coblader/mousedroid/cad/comments2.png

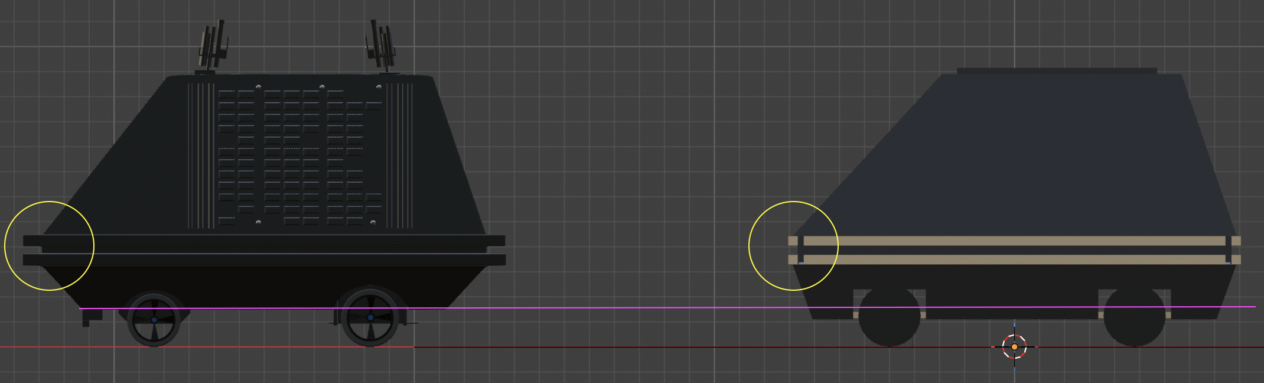
cad/comments2.png
