coblader/mousedroid/cad/comments.png

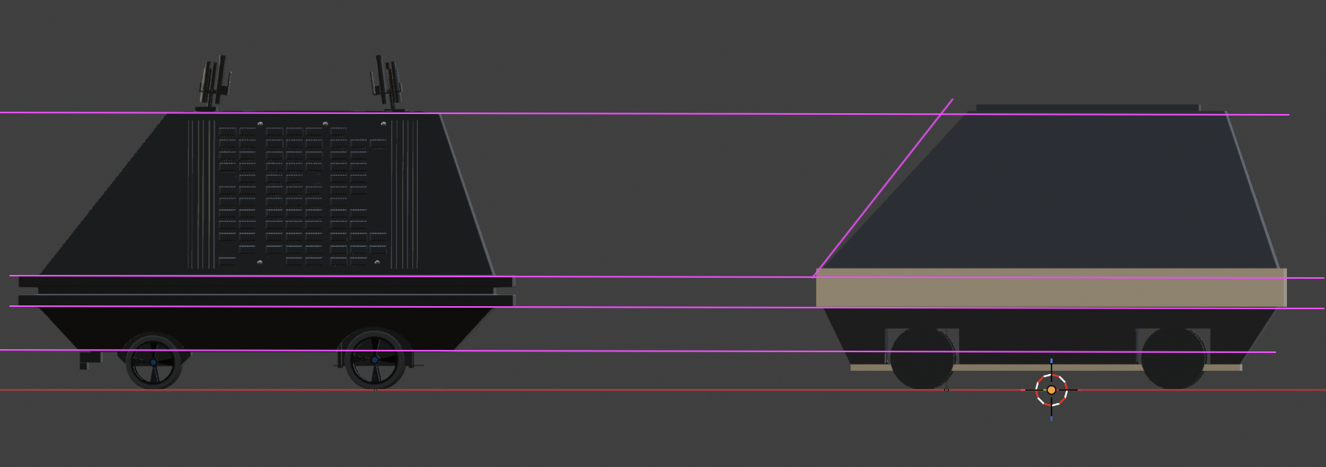
cad/comments.png
