coblader/mousedroid/chassis/4wd-mecanum-wheel-robot-chassis-metal-frame.jpg.webp

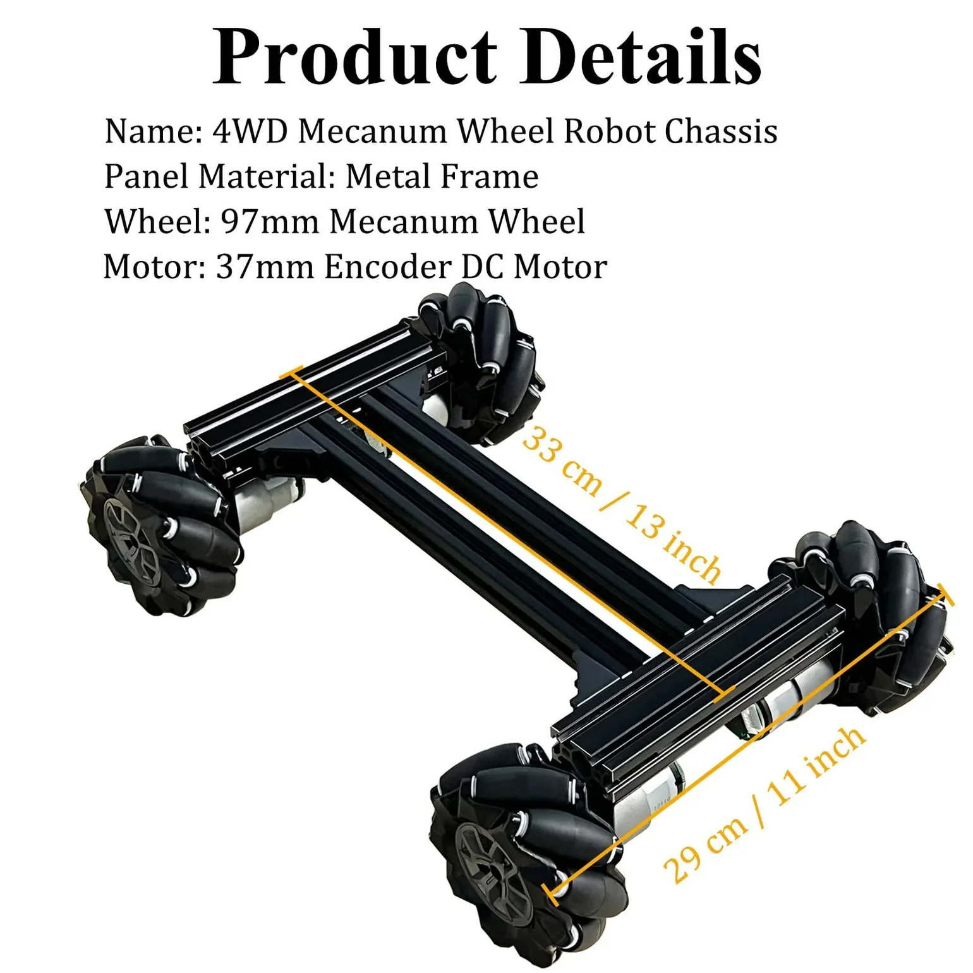
chassis/4wd-mecanum-wheel-robot-chassis-metal-frame.jpg.webp
