coblader/mousedroid/chassis/4wd-mecanum-wheel-robot-chassis-side-view.jpg.webp

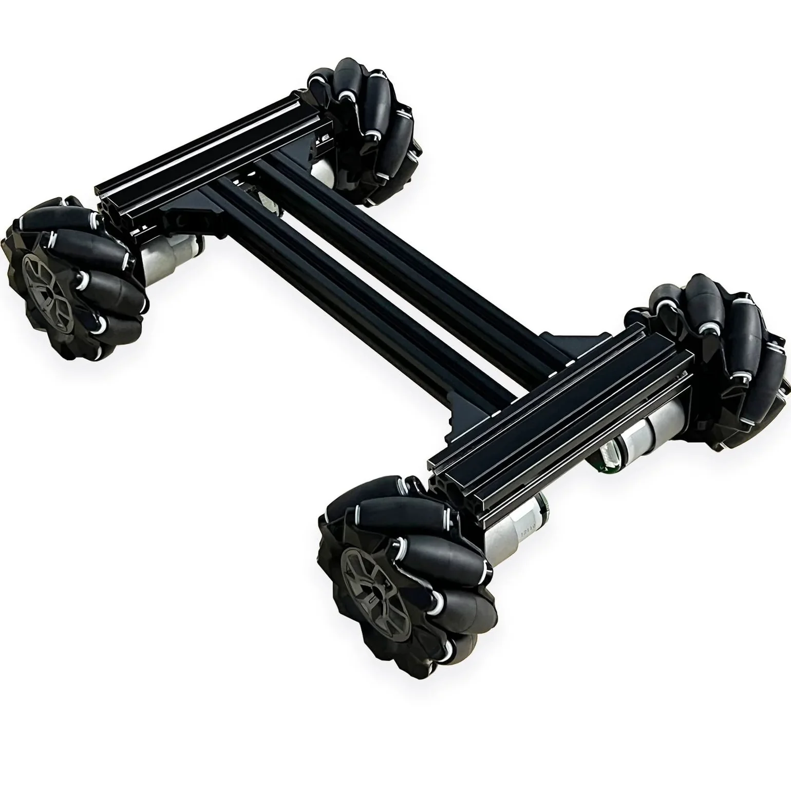
chassis/4wd-mecanum-wheel-robot-chassis-side-view.jpg.webp
