coblader/mousedroid/chassis/4wd-mecanum-wheel-robot-metal-chassis-kit.jpg.webp

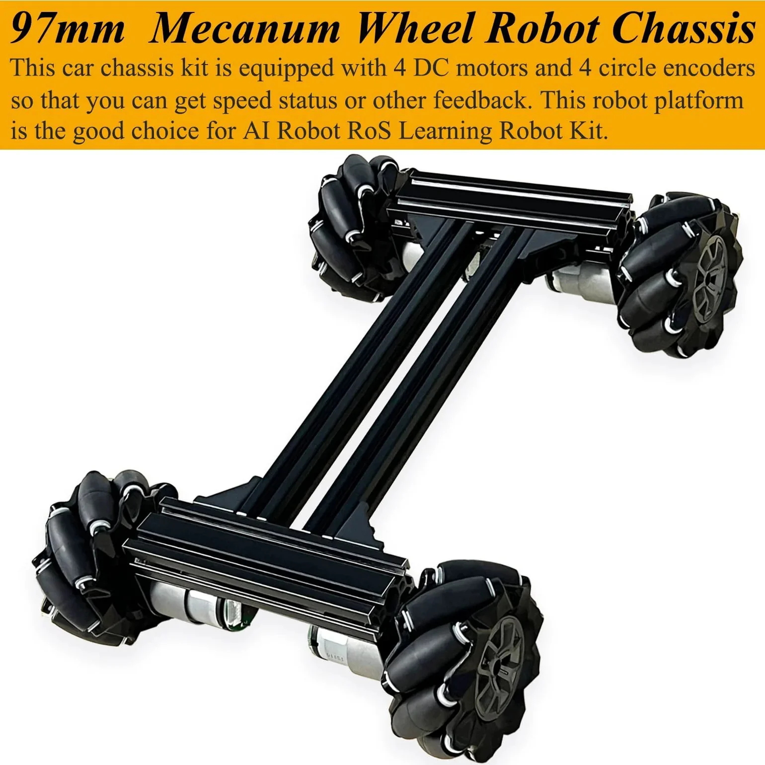
chassis/4wd-mecanum-wheel-robot-metal-chassis-kit.jpg.webp
