coblader/mousedroid/chassis/4wd-mecanum-wheel-robot-metal-frame-black.jpg.webp

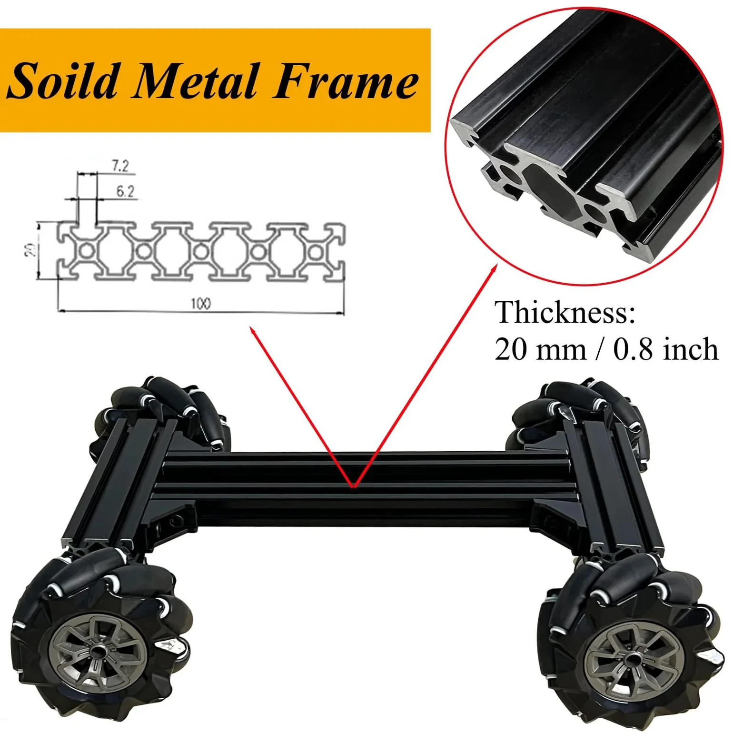
chassis/4wd-mecanum-wheel-robot-metal-frame-black.jpg.webp
