coblader/mousedroid/chassis/4wd-mecanum-wheel-robot-motor-encoder-diagram.jpg.webp

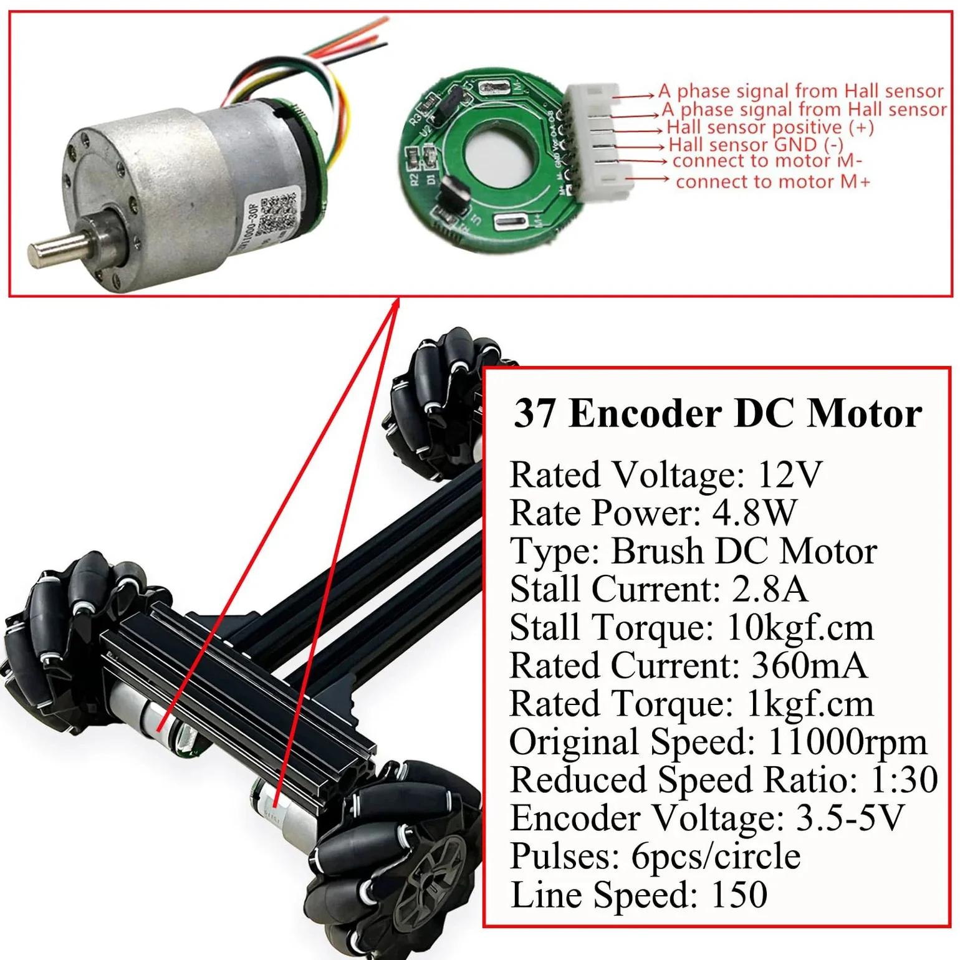
chassis/4wd-mecanum-wheel-robot-motor-encoder-diagram.jpg.webp
