coblader/mousedroid/chassis/97mm-mecanum-wheel-diagram-and-design.jpg.webp

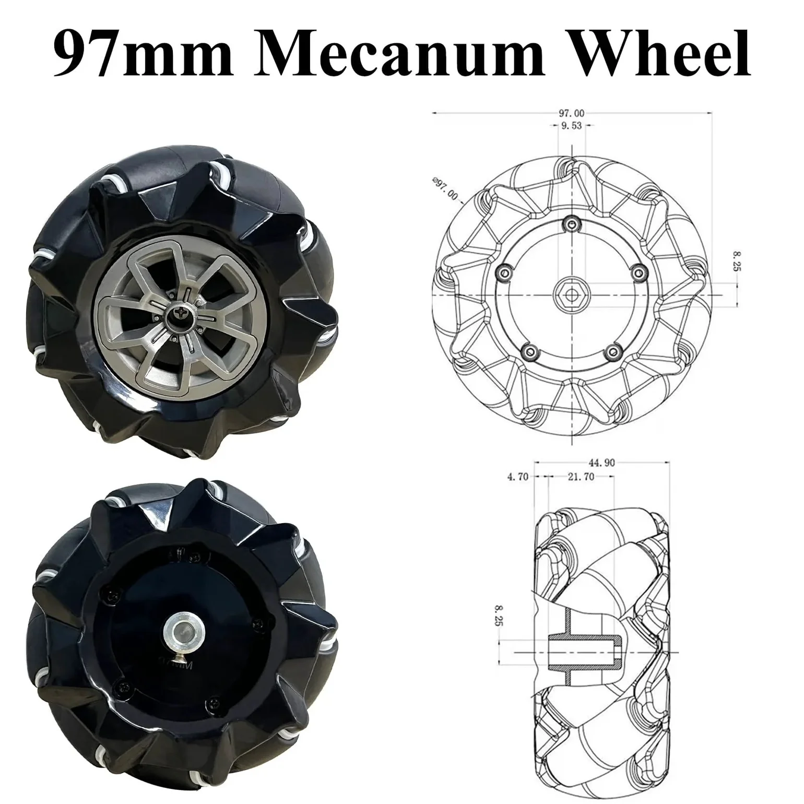
chassis/97mm-mecanum-wheel-diagram-and-design.jpg.webp
