coblader/mousedroid/chassis/chassis.png

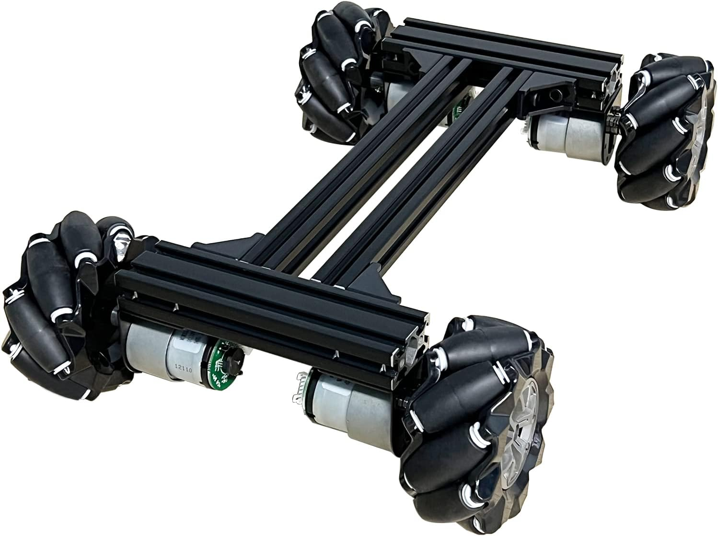
chassis/chassis.png
