coblader/mousedroid/firmware/encoder.png

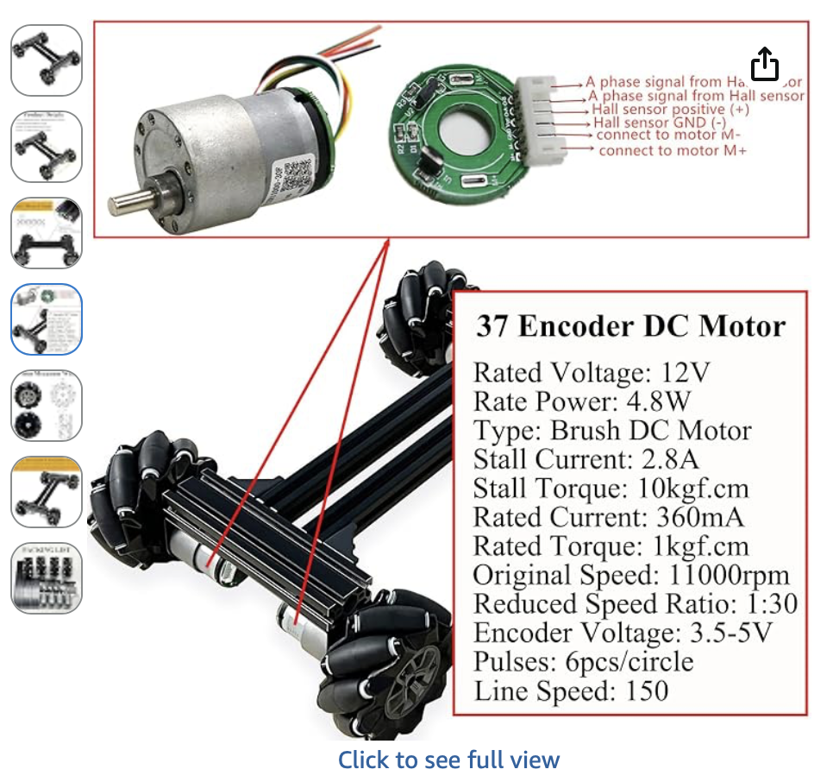
firmware/encoder.png
