coblader/mousedroid/chassis/4wd-mecanum-wheel-robot-parts-kit.jpg.webp

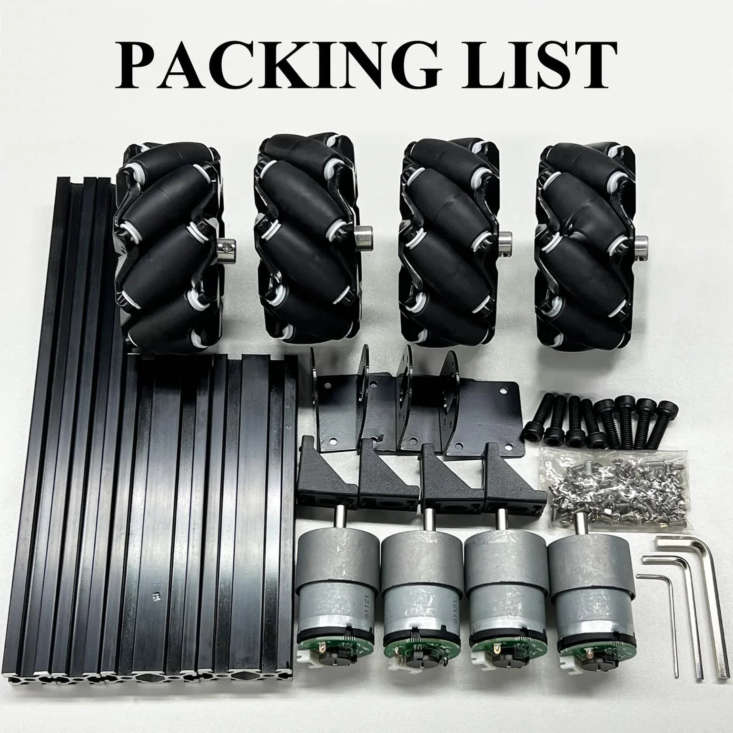
chassis/4wd-mecanum-wheel-robot-parts-kit.jpg.webp
