coblader/mousedroid/cad/Mse-6/Mse-6-for-animation/Mse.OBJ-.MTL/Mse6-WithoutWheels/Msewithoutwheels.obj

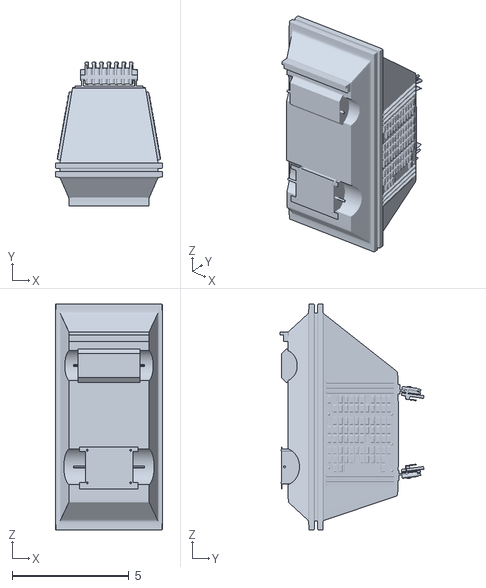
[picture p12: CAD file, 2026-07-14]
cad/Mse-6/Mse-6-for-animation/Mse.OBJ-.MTL/Mse6-WithoutWheels/Msewithoutwheels.obj
4.57 x 6.15 x 9.66
