coblader/mousedroid/cad/Mse-6/Mse-6-for-animation/Mse.OBJ-.MTL/Wheels/wheels.obj

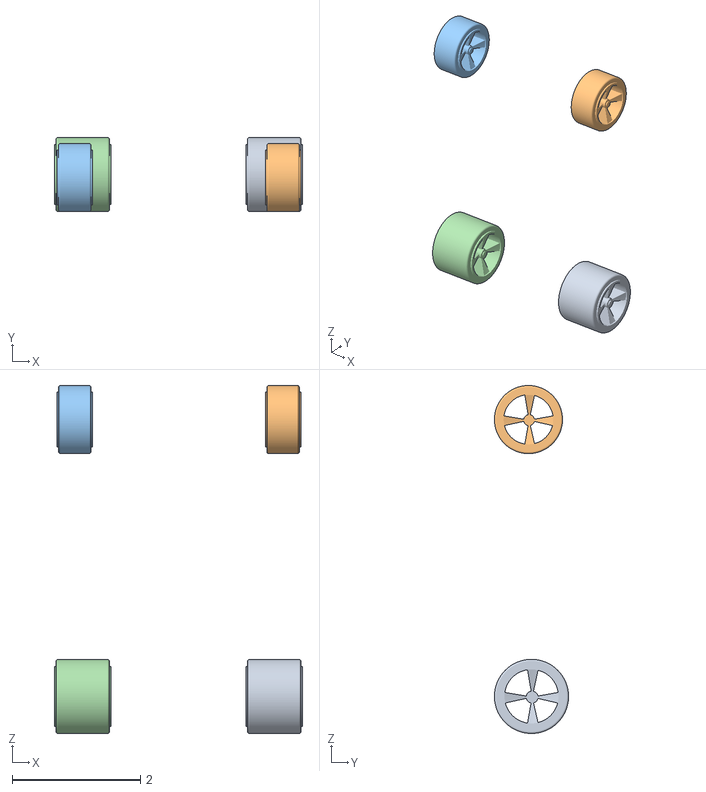
[picture p13: CAD file, 2026-07-14]
cad/Mse-6/Mse-6-for-animation/Mse.OBJ-.MTL/Wheels/wheels.obj
3.88 x 1.16 x 5.44
wheel2right_Circle.002
wheel1right_Circle.001
wheel1left_Circle.004
wheel2left_Circle.003
