coblader/mousedroid/(list of files, cad)

Other CAD files:
cad/mouse-droid.blend
