coblader/mousedroid/firmware/WIRING.md

# Mouse Droid — Wiring

Skid-steer 4WD. Left pair of motors on BTS7960 #1, right pair on BTS7960 #2.
Arduino Uno = motor controller (USB-powered from Jetson). One encoder channel read
per side (**single-channel** — 3 of 4 encoder A channels are dead; see below).

## 1. Power distribution (thick wire, 12–14 AWG)

```
        3S LiPo 11.1V ── XT60
             │ (+)
             ▼
      [ 15A inline fuse ]
             │
             ▼
      [ 20A main switch ]
             │  +12V (switched) bus
   ┌─────────┼───────────────────┬───────────────────────┐
   ▼         ▼                   ▼                        ▼
BTS7960 #1  BTS7960 #2      Buck-boost IN            (Vbat divider tap,
 B+  B-      B+  B-          IN+   IN-                 see signal view)
                              │ OUT = 12V
                              ▼
                    [ 5.5x2.5 barrel, CENTER +] ── verify with meter!
                              ▼
                    Jetson Orin Nano DC jack

GROUND BUS (battery −):  battery− ─ BTS7960#1 B− ─ BTS7960#2 B− ─
                         buck-boost IN− ─ Arduino GND ─ MPU6050 GND ─
                         divider GND   (ALL tied together — one common ground)
```

**Main on/off switch:** SPST in the **+12 V line, right after the fuse** — one
terminal from the fuse output, the other to the +12 V bus (it breaks the positive
only; ground stays continuous). Carries full system current, so use thick 12–14
AWG (20 A switch > 15 A fuse). An *illuminated* rocker has a 3rd terminal = lamp
(−) → common ground. The switch cuts **everything**, including the Jetson.

**LiPo low-voltage buzzer:** standalone alarm — plugs into the pack's **JST-XH
balance lead**; not wired to the Arduino or the bus. Per-cell audible warning that
complements the firmware cutoff (see BUILD.md §5).

**Jetson audio peripherals (NOT on the Arduino):** the speaker (MAX98357A I²S amp
off the Orin 40-pin I²S + 5 V) and the ReSpeaker USB mic array (USB) connect to the
**Jetson**. See BUILD.md §3 (BOM) and §8 (voice → VLM pipeline).

## 2. Motors (each driver runs its two motors in parallel)

```
BTS7960 #1 (LEFT)                    BTS7960 #2 (RIGHT)
  M+ ─┬─ Left-Front  (+)               M+ ─┬─ Right-Front (+)
  M- ─┤   Left-Front  (-)              M- ─┤   Right-Front (-)
      └─ Left-Rear   (+/-)                 └─ Right-Rear  (+/-)
```

## 3. Signal / logic (thin jumper wire)

```
Jetson Orin Nano ──── USB (data + powers Uno) ──── Arduino Uno
Arducam IMX219  ──── 22-pin MIPI-CSI ──────────── Jetson

Arduino Uno                         BTS7960 #1 (LEFT)
  D5  ──────────────────────────►   RPWM
  D6  ──────────────────────────►   LPWM
  D8  ──┬───────────────────────►   R_EN + L_EN (tied)
  5V  ──┼──────────────────────►    VCC (logic)
  GND ──┼──────────────────────►    GND (logic)
        │                           BTS7960 #2 (RIGHT)
  D9  ──┼───────────────────────►   RPWM
  D10 ──┼───────────────────────►   LPWM
  D8  ──┘  (same enable line)   ►    R_EN + L_EN (tied)
                                     VCC ◄ 5V,  GND ◄ GND

LEFT motor encoder (6-wire)          Arduino   (SINGLE-CHANNEL — see note)
  working signal ─────────────►      D2  (interrupt)   one channel only
  Hall +   ◄───────────────────      5V
  Hall GND ◄───────────────────      GND
  (2nd signal wire)                  D4  UNUSED
  M+ / M-  ── to BTS7960 #1 M+/M-

RIGHT motor encoder (6-wire)         Arduino
  working signal ─────────────►      D3  (interrupt)   one channel only
  Hall +   ◄─ 5V   Hall GND ◄─ GND
  (2nd signal wire)                  D7  UNUSED
  M+ / M-  ── to BTS7960 #2 M+/M-

MPU6050          Battery sense divider
  VCC ◄ 5V         +12V ─[R1 10k]─┬─[R2 3.3k]─ GND
  GND ◄ GND                       └──► A0
  SDA ► A4
  SCL ► A5
```

### Encoder connector pinout (6-pin JST on each motor)

Each motor breaks out to ONE 6-pin plug that carries **both** the encoder
signals (thin, to the Arduino) and the motor power (fat, to the BTS7960). Pin
order below matches the vendor diagram (`../chassis/4wd-mecanum-wheel-robot-motor-encoder-diagram.jpg.webp`).

```
Pin  Vendor label                       Actually is        Wire to (LEFT / RIGHT)
 1   "A phase signal from Hall sensor"  Encoder A phase    D2  / D3   (interrupt)
 2   "A phase signal from Hall sensor"  Encoder B phase *  D4  / D7
 3   Hall sensor positive (+)           Encoder Vcc 3.5-5V 5V
 4   Hall sensor GND (-)                Encoder GND        GND
 5   connect to motor M-                Motor -            BTS7960 M-
 6   connect to motor M+                Motor +            BTS7960 M+
```

* **The vendor diagram double-labels pins 1 & 2 both as "A phase" — that is a
  typo.** A 6-wire Hall encoder has two quadrature outputs; pin 2 is the **B
  phase**.
* **SINGLE-CHANNEL on this build (2026-07-22):** 3 of the 4 motors' encoder A
  channels turned out dead. The firmware now reads just **one working channel per
  side** on the interrupt pin (D2 left / D3 right) and infers direction from the
  commanded PWM sign — it does **not** compare A vs B. Wire the wheel's one
  *toggling* signal (whichever channel works) to D2/D3; **D4/D7 are unused**.
  There is no A/B swap to fix a sign — instead make the motor spin forward on a
  positive command (swap that side's M+/M-). See BUILD.md §7 and AGENT_LOG.md.
* Encoder logic is 3.5-5 V, so the Uno's **5V** rail is in range.
* Spec check: 6 pulses/rev × 1:30 gearbox, counted on CHANGE of A (2 edges) =
  360 counts per wheel revolution → firmware `COUNTS_PER_REV = 360`.

## Connection table (Arduino Uno)

| Uno pin | To | Notes |
|---|---|---|
| D2 | LEFT encoder signal (single channel) | hardware interrupt |
| D3 | RIGHT encoder signal (single channel) | hardware interrupt |
| D4 | unused (was LEFT encoder B) | single-channel — see note |
| D7 | unused (was RIGHT encoder B) | single-channel — see note |
| D5 / D6 | BTS7960#1 RPWM / LPWM | PWM |
| D9 / D10 | BTS7960#2 RPWM / LPWM | PWM |
| D8 | all four BTS enables | HIGH=run, LOW=e-stop |
| A0 | divider junction | Vbat sense |
| A4 / A5 | MPU6050 SDA / SCL | I2C |
| 5V | encoder Hall+ ×2, BTS VCC ×2, MPU VCC | logic power |
| GND | common ground bus | **must tie to battery −** |
| USB | Jetson | data + powers Uno |

## Critical notes
- **One common ground** — the #1 cause of flaky encoder/PWM behavior is the
  Arduino/logic ground not being tied to the motor-power (battery −) ground.
- **Single-channel encoders — one channel per side is read** (D2/D3). 3 of the 4
  motors' encoder A channels are dead, so the firmware reads one working channel
  per side and infers direction from the commanded PWM sign (not quadrature);
  D4/D7 unused. The other motor on each side still gets M+/M- power; its encoder
  can be left unconnected. See BUILD.md §7 / AGENT_LOG.md.
- **Right side M+/M- are reversed vs the left** (the motors are mirror-mounted) so
  a positive command drives both sides forward — expected, not a mistake.
- **Barrel plug polarity: center positive.** Meter it before plugging the Jetson.
- Keep the fat 12V motor wiring physically away from the thin encoder/signal wires.
- The main switch cuts everything including the Jetson (buck-boost taps the switched bus).
```
