coblader/mousedroid/(commit log)

2026-07-14 initial commit of cad and hardware files
    [Msewithoutwheels.obj, mouse-droid.blend, wheels.obj]
2026-07-17 Document 6-pin encoder connector pinout; add chassis reference images
    Add the vendor 6-pin JST pinout to firmware/WIRING.md, mapping each pin
    (A/B phase, Vcc, GND, M-, M+) to its LEFT/RIGHT Arduino destination, and
    note that the vendor diagram's duplicate "A phase" label on pin 2 is a
    typo (it's the B phase). Commit the chassis/ reference photos, including
    the encoder diagram the doc now links to.
2026-07-17 Add .gitignore for .DS_Store; drop tracked .DS_Store files
    Ignore .DS_Store in all directories/subdirectories and remove the three
    that were already committed under cad/.
2026-07-17 Add CLAUDE.md conventions and AGENT_LOG.md for multi-agent coordination
    CLAUDE.md captures repo conventions (two-brain architecture, edit-by-hand
    rules for binary CAD, firmware safety-constant verification, commit/push
    discipline) and a multi-agent coordination section: one branch per agent,
    prefer worktrees, read/update the log. AGENT_LOG.md is the shared running
    log (active-work table + newest-first history) seeded with today's work
    and the open follow-ups.
2026-07-18 Log hardware bring-up progress (paused mid encoder-B diagnosis)
    Record bench bring-up state: firmware flashed from the Jetson via
    arduino-cli and serial verified; LEFT encoder A (D2) working; B channel
    (D4) intermittent, pinning TEL L at 0/+-35. Captures the "identify signal
    wires by which two toggle" method, the enc_test diagnostic sketch (local
    to the Jetson, not in repo), and the definitive next step (count delta
    over one full wheel revolution), then the remaining bring-up sequence.
2026-07-21 Add open-loop motor test sketch; log drivetrain bring-up
    Bench bring-up of the motor/BTS7960 stage (open-loop, on blocks, 12V/5A
    wall adapter + 5A fuse). All four motors now wired and verified spinning
    forward together via L120 R120.
    - firmware/motor_test/motor_test.ino: open-loop diagnostic (raw PWM over
    serial, no PID/encoders) so driver+motor wiring can be verified without
    depending on the still-flaky encoder-B channel.
    - AGENT_LOG.md: full bring-up record — left/right side verification, the
    mirror-mount M+/M- reversal on the right, two right-side wiring shorts
    found and cleared, and next steps (encoder fix, closed-loop, power stage).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
    [motor_test.ino]
2026-07-22 Disable IMU until drivetrain is solid
    Set IMU_ENABLED = false in the flight sketch: the MPU6050 is still unwired
    and not yet folded into the control loop, so skip its ~0.6s startup gyro
    calibration and yaw-rate reads for now. Re-enable when the encoder/PID
    drivetrain is verified and heading-hold is implemented (BUILD.md §13).
    [mouse_droid_controller.ino]
2026-07-23 Add reusable tools/motor_test.py + tools README; log fuse fix
    - tools/motor_test.py: CLI motor bench tester over serial (-l/-r PWM,
    -s duration, --check, -p port). Health-gates the Uno and refuses to
    command motion if it's unresponsive (catches wiring-short brownouts).
    Replaces the ad-hoc inline pyserial snippets used during bring-up.
    - tools/README.md: documents the tools/ dir and script, with a convention
    for adding future bring-up scripts.
    - AGENT_LOG.md: recorded that the "wheels not spinning" scare was a blown
    5A inline fuse (from an earlier short); replaced -> all four run forward.
    [motor_test.py]
2026-07-23 Add encoder/drivetrain test tools; log encoder bring-up (paused)
    Encoder verification stage of the drivetrain bring-up. All 4 motors drive
    forward open-loop; encoder bring-up is the remaining blocker.
    - firmware/encoder_test/encoder_test.ino: reads encoder counts + live A/B
    pin levels (send 'z' to zero) for the one-revolution hand-turn check.
    - firmware/drivetrain_test/drivetrain_test.ino: open-loop drive + encoder
    count + A/B levels in one sketch, so encoders can be verified UNDER POWER
    (far more reliable than hand-backdriving the gearbox).
    - tools/encoder_test.py + tools/README.md: host-side encoder reader/harness.
    - AGENT_LOG.md: full encoder debug trail and a RESUME-HERE block. Pr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
2026-07-23 Switch to single-channel encoders (3/4 A channels dead)
    Meter-testing found 3 of the 4 motor encoder A channels are dead (only B
    channels work). Rather than replace motors now, drive the velocity loop
    from a single working channel per side and infer direction from the
    commanded PWM sign.
    - mouse_droid_controller.ino: read one channel per side on the interrupt
    pins (D2 left, D3 right); count every edge; leftDir/rightDir set from the
    applied PWM sign. D4/D7 unused. COUNTS_PER_REV unchanged (360). Since the
    measured sign follows the command, motor direction must be physically
    correct (already verified) - no encoder A/B swap applies.
    - drivetrain_test.ino: matching single-channel counti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
    [drivetrain_test.ino, mouse_droid_controller.ino]
2026-07-23 Closed-loop drivetrain working; add bench battery-monitor toggle
    Add BATTERY_MONITOR_ENABLED flag (false for bench testing on the DC
    adapter, where the A0 divider isn't wired and a floating A0 would latch a
    false FAULT_LOWV and disable the motors). Must be set true - with the A0
    divider wired - when running on the LiPo; over-discharge protection is
    mandatory for a 3S pack.
    Verified on the bench: flashed the flight firmware and both sides hold
    commanded velocity via PID on the single-channel encoder feedback
    (L100 R0 -> TEL L ~100; L100 R100 -> both L and R ~100 mm/s). The full
    Arduino real-time control loop is functional.
    AGENT_LOG.md: closed-loop verification + remaining work (PID tune, w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
2026-07-23 Update BUILD.md + WIRING.md for single-channel encoders
    Bring the docs in line with the as-built drivetrain:
    - Pin maps: D2/D3 = single encoder signal per side (interrupt); D4/D7 now
    unused (were the B channels).
    - Explain single-channel encoders (3/4 A channels dead): speed from one
    channel, direction from the commanded PWM sign, so motor direction must
    be physically correct (no A/B sign swap).
    - Firmware config: note IMU_ENABLED and BATTERY_MONITOR_ENABLED flags;
    WHEEL_DIAMETER_MM still a placeholder; verify COUNTS_PER_REV under power.
    - Bring-up step 6 reworded (sign follows the command now).
    - WIRING: encoder diagram, connector-pinout note, connection table, and
    critical notes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
2026-07-23 BUILD.md: add speaker (Jetson-controlled), LiPo buzzer + divider resistors
    - §1/§2/§8: audio is a Jetson responsibility - the Jetson plays the MSE-6
    sounds through a speaker; add a planned `sounds` module alongside the
    serial wrapper. Arduino stays motion-only.
    - §3 BOM: new Audio section (MAX98357A I2S amp + small speaker, or a USB/BT
    speaker to prototype); LiPo low-voltage buzzer; A0 divider resistors
    (10k + 3.3k, 1% 1/4W). MPU6050 row notes GY-521 needs no extra resistors
    (onboard pull-ups + regulator, 4 jumpers only).
    - §5 safety: two-layer LiPo protection - firmware cutoff (A0 divider) AND a
    balance-lead buzzer (per-cell alarm).
    - AGENT_LOG.md: order list + remaining-wo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
2026-07-24 BUILD.md: add mic (ReSpeaker) + voice→VLM command pipeline
    - §1/§2: the Jetson now also takes voice input (STT→VLM); note Jetson I/O
    (Arducam + ReSpeaker mic in; drive commands + speaker out).
    - §3 BOM: add ReSpeaker USB Mic Array v2.0 to the Audio & voice section.
    - §8: document the planned layered voice+VLM pipeline — mic → wake word →
    Whisper STT → (text + camera frame) → VLM planner → goal → fast tracker →
    serial. VLM stays OUT of the real-time loop (slow high-level planner);
    on-Orin-Nano model notes (Whisper + small VLM) or cloud VLM.
    - AGENT_LOG.md: updated order list + pipeline note.
2026-07-24 Add 'still to order' checklist (BUILD) + switch/buzzer/audio wiring notes
    - BUILD.md §3: a "Still to order" checklist of the outstanding electronics
    purchases (divider resistors, LiPo buzzer, ReSpeaker mic, speaker audio),
    noting the MPU needs no extra parts and the power parts are already sourced.
    - WIRING.md §1: main on/off switch terminal wiring (SPST in the +12V line
    after the fuse; illuminated 3-terminal variant); LiPo balance-lead buzzer;
    and a note that the speaker + mic are Jetson peripherals, not Arduino.
2026-07-24 Add jetson/ control software + follow-person end-to-end demo
    Consolidate the Jetson-side scripts into the repo and build the first
    end-to-end example: camera -> VLM -> Arduino -> feedback (follow a person).
    Moved in from ~ (existing, tested): capture_camera.py (CsiCamera + gray-world
    WB), ask_camera.py (VLM query via Ollama), setup_ollama_qwen.sh,
    enable_imx219_camera.sh, capture_camera.sh, bench_vlms.py, vlm_bench/.
    New control stack (reuses the camera + Ollama and the firmware serial protocol):
    - serial_link.py: MouseDroid — drive()/stop()/telemetry over serial, with a
    heartbeat thread so the firmware's 500ms failsafe doesn't stall the motors
    between slow VLM frames.
    - detection.py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
    [ask_camera.py, bench_vlms.py, capture_camera.py, check_serial.py, control.py, detection.py, follow_person.py]
2026-07-24 Add jetson bring-up log; check_serial default avoids hard reverse
    - jetson/check_serial.py: default drive pattern is forward + gentle
    differential turn (no hard reverse); hard-reverse spin is opt-in via --spin
    with a fuse warning.
    - AGENT_LOG.md: serial_link validated live (forward tracks ~120 mm/s
    closed-loop). Root-caused the "second motion phase reads 0": the forward->stop
    transition makes the PID actively brake (drive reverse), whose plugging
    current spike trips the 5A bench adapter. Bench-supply limit, not a fault -
    LiPo + 15A fuse handles it. Options noted: lower bench speed, a firmware
    coast-on-stop tweak, or move to the LiPo for a smooth end-to-end run.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
    [check_serial.py]
2026-07-24 Scale-aware VLM box parsing; log end-of-session state
    - jetson/vlm_locator.py: parse person boxes robustly across coordinate
    scales (0-1 normalized / absolute pixels / 0-1000 grid) via per-axis
    _normalize(); add MOUSEDROID_VLM_DEBUG=1 to print the raw VLM response.
    (The dry-run returned a degenerate cx=1.00/area=0.00 because Qwen emits
    non-0-1 coords that were being clamped to 1.0.)
    - AGENT_LOG.md: perception pipeline validated end-to-end (dry-run: camera ->
    Qwen2.5VL:3b -> parse -> controller -> command; ~74s first call). Recorded
    the coord-scale fix (pending re-verify) and the escalated motor-power issue
    (5A fuse now blows on connect = a short; suspect a BTS7960 damaged by th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
    [vlm_locator.py]
